zemli777/keyboard/README.md

# Клавиатура на 64 кнопки

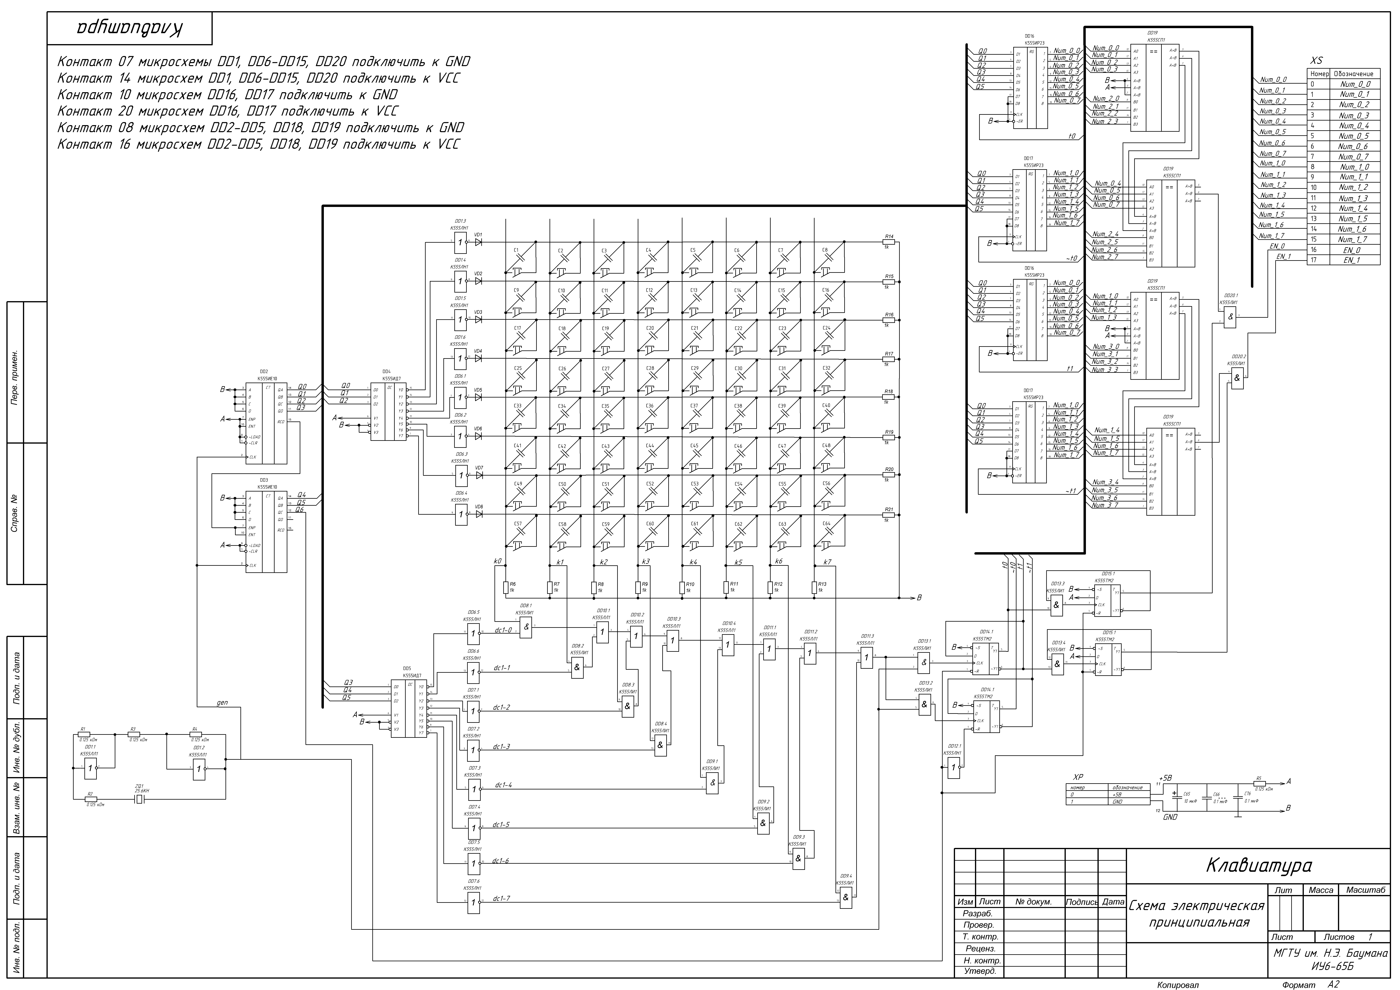
[picture p1: принципиальная.png]
