zemli777/keyboard/спецификация.pdf

Подп. и дата Взам. инв. № Инв. № подл Подп. и дата

Инв. № дубл.

Микросхемы

DD1, DD6, DD7, DD12 | К555ЛН1 | 4
DD2, DD3 | К555ИЕ10 | 2
DD4, DD5 | К555ИД7 | 2
DD8, DD9, DD13, DD24 | К555ЛИ1 | 4
DD10, DD11 | К555ЛЛ1 | 2
DD14, DD15 | К555ТМ2 | 2
DD16-DD19 | К555ИР23 | 4
DD20-DD23 | К555СП1 | 4
R1 | МЛТ 0,125 - 0,56 кОм | 1
R2,R3 | МЛТ 0,125 - 0,22 кОм | 2
R4 | МЛТ 0,125 - 1,8 кОм | 1
R5-R21 | МЛТ 0,125 - 1 кОм | 17

Резисторы

Конденсаторы

С1-C64, C66-C78 | К50-68-25-0.1мФ ГОСТ 5-635-70 | 77
C65 | К50-68-25-10мкФ ГОСТ 5-635-70 | 1

Утв.

Изм. | Лист | № докум | Подпись | Дата
| | Разраб. | | | Перечень элементов | Литера | Лист | Листов
Пров. | | | | | Т | | 1 | 1
XS | HDMI | 1
XP | SP2112/P2 | 1
| | Клавиатура

Формат
Зона
Поз.

А3

Кол.

| Обозначение | Наименование | | Приме-чание
| | Документация
| | Схема электрическая | 1
А3 | | функциональная
| | Схема электрическая | 1
А2 | | принципиальная
| | Временные диаграммы | 1

Разьемы

МГТУ им. Н.Э. Баумана
каф. ИУ6
Группа ИУ6-65Б
