zemli777/keyboard/временные диаграммы.png

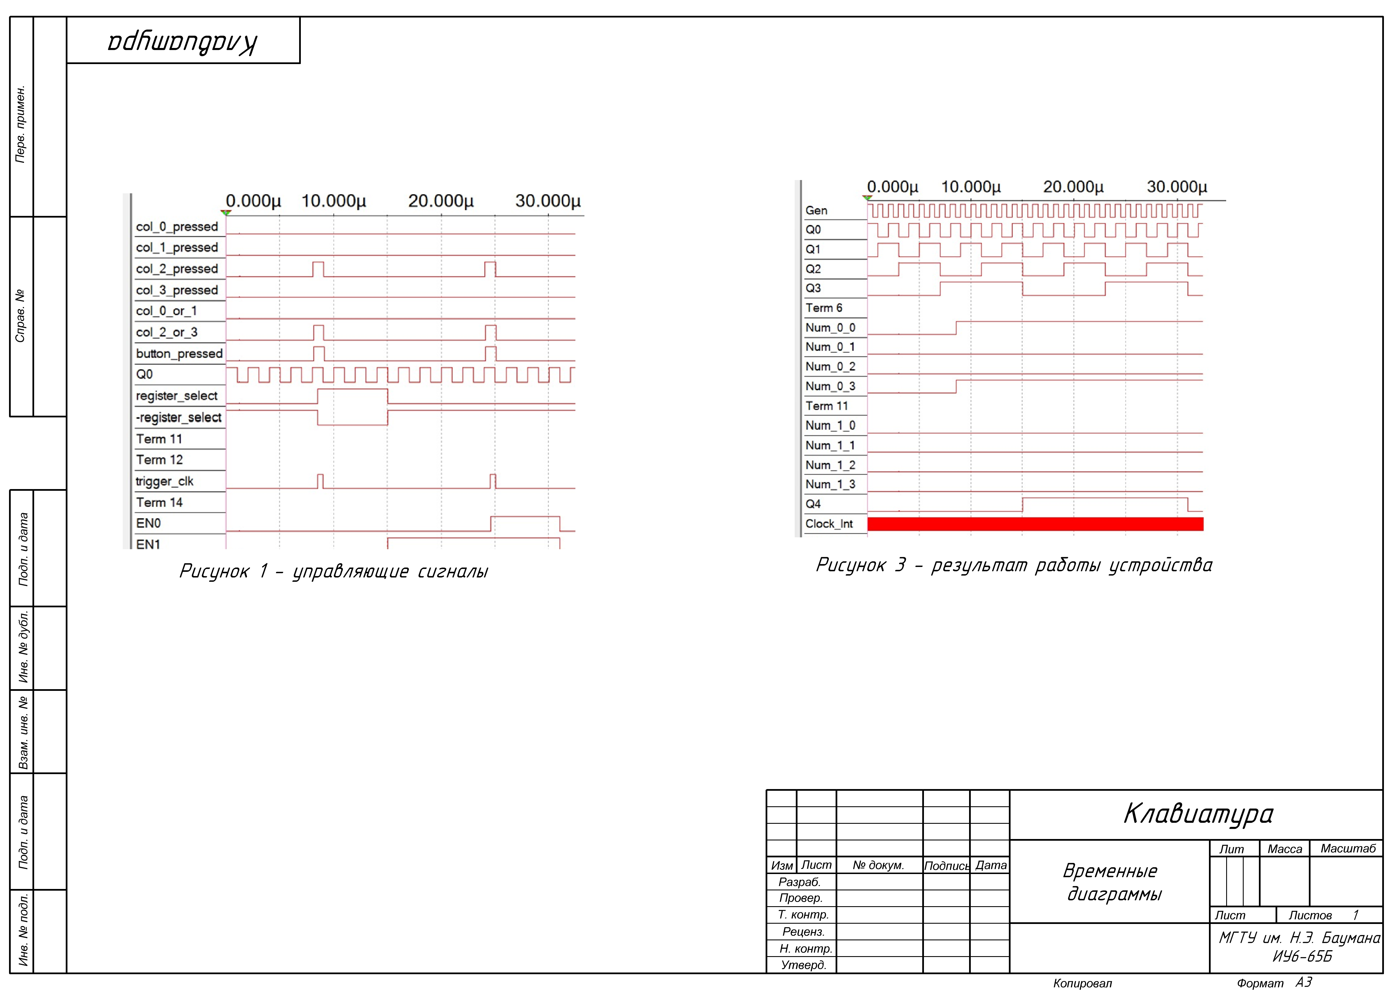
временные диаграммы.png
