zemli777/keyboard/функциональная.png

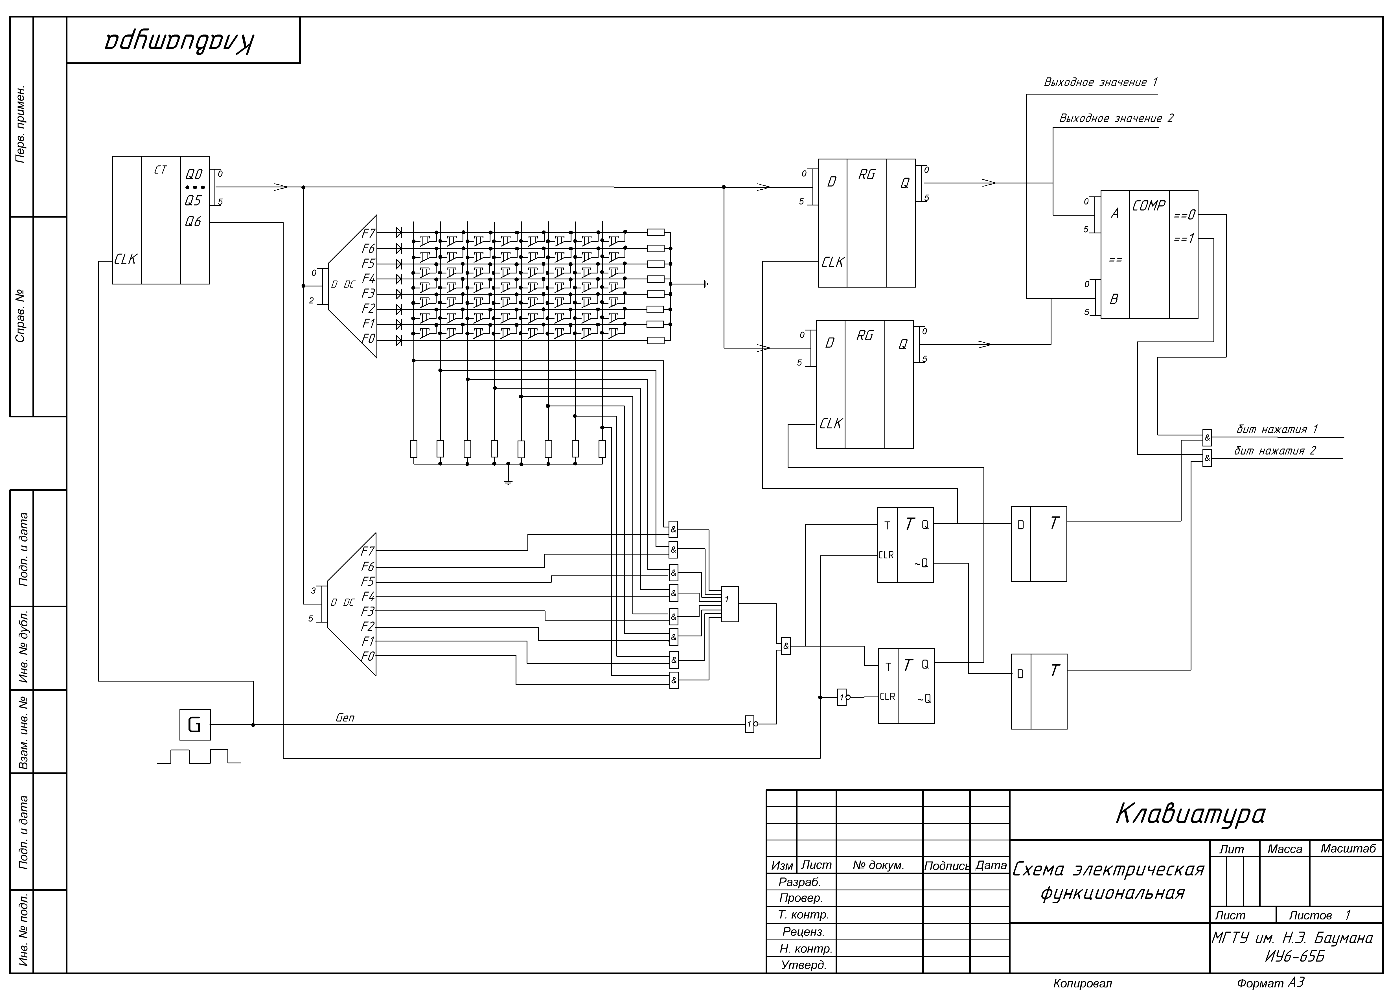
функциональная.png
