zemli777/keyboard/(list of files, drawings)

Other design files:
myclava.ms14
